AnterCreeper/gAFx/pickguard/pickguard.stl

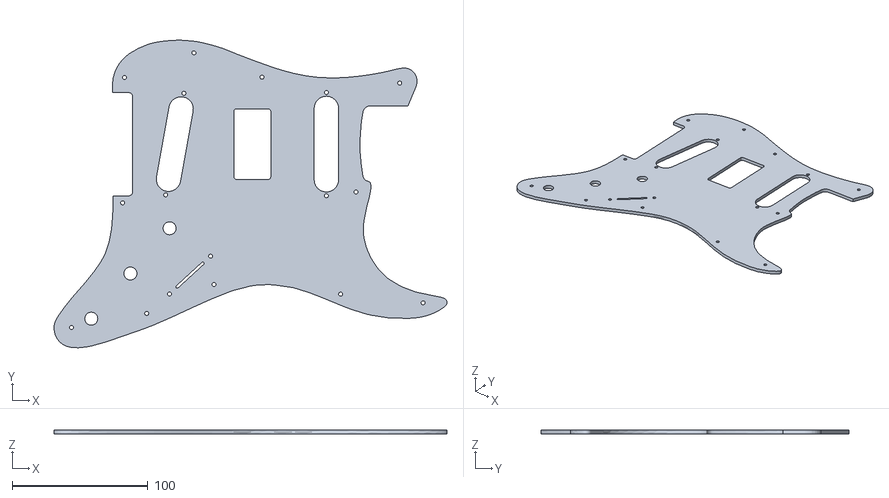
[picture p1: CAD file, 2025-06-01]
pickguard/pickguard.stl
289.1 x 226.3 x 3.00
