AnterCreeper/gAFx/(list of files, cad)

Other CAD files:
pickguard/pickguard.dxf
