AnterCreeper/gAFx/core/audio_lab.kicad_pcb

## KiCad design core/audio_lab.kicad_pcb (2025-06-01)

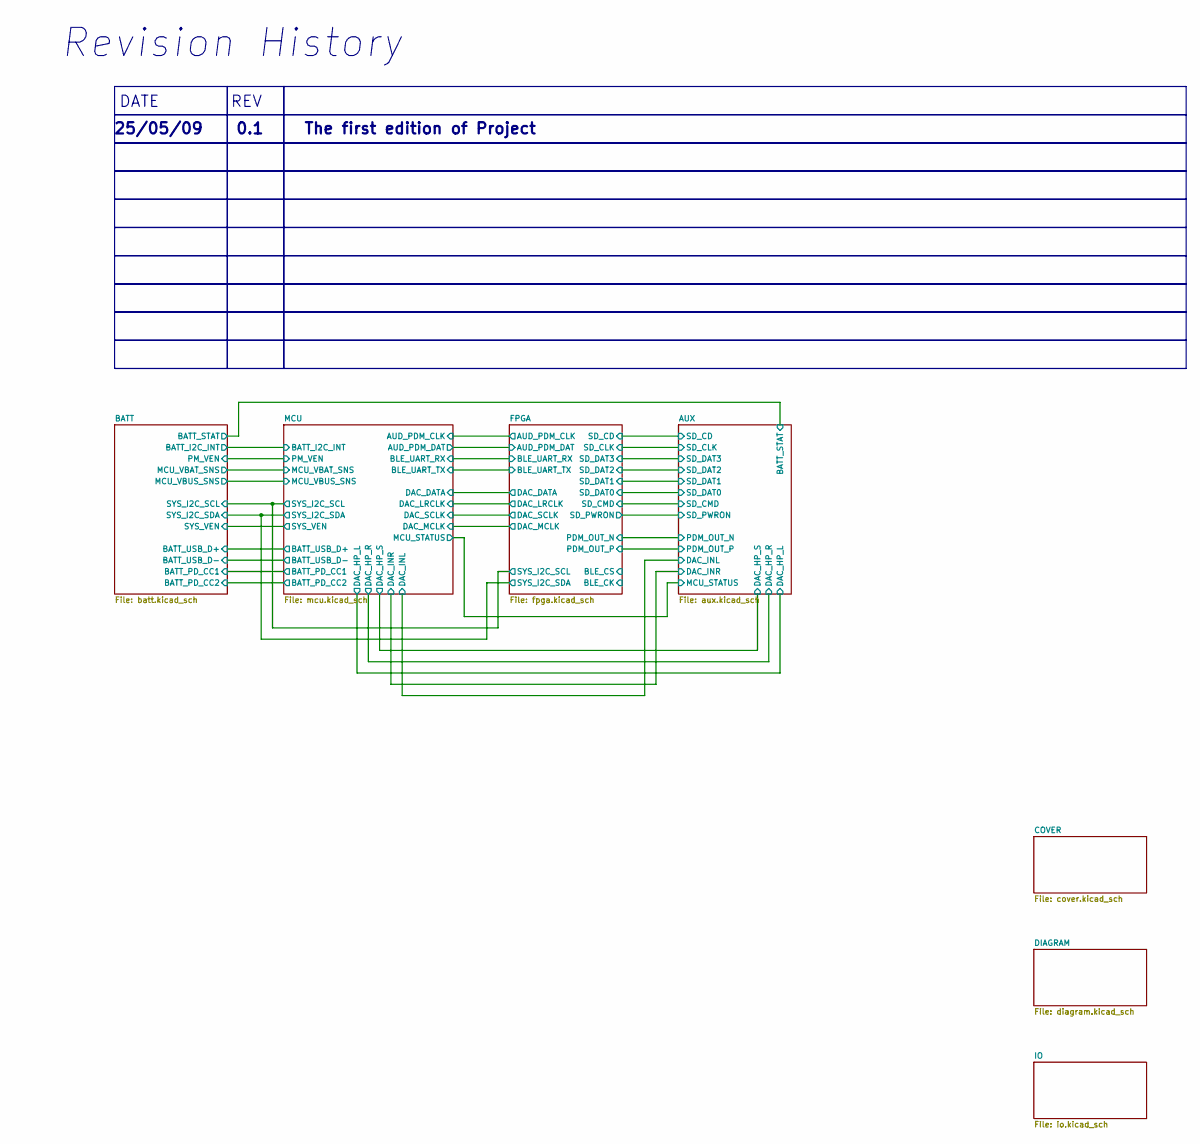
[picture p2: schematic audio_lab.kicad_sch]

Notes on the sheet:
Revision History
REV
0.1
25/05/09
The first edition of Project
DATE

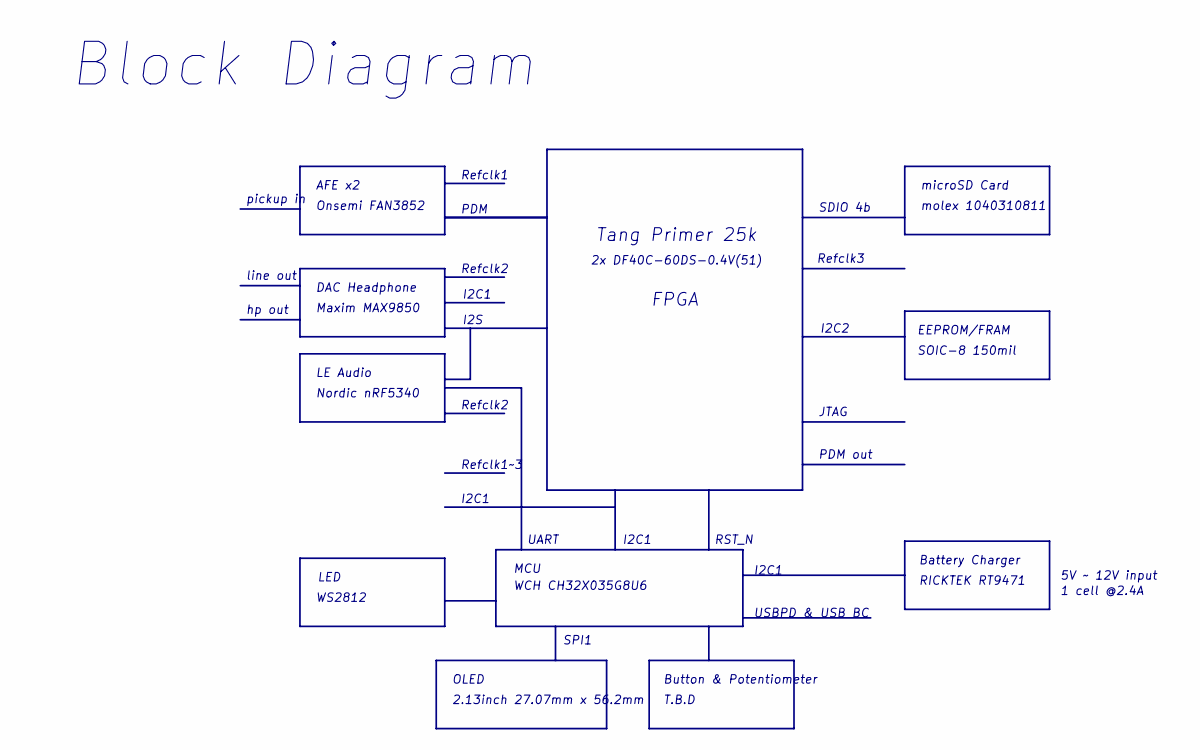
[picture p3: schematic diagram.kicad_sch]

Notes on the sheet:
T.B.D
Onsemi FAN3852
line out
FPGA
PDM out
WCH CH32X035G8U6
5V ~ 12V input
Refclk2
USBPD & USB BC
Refclk3
JTAG
EEPROM/FRAM
Refclk1
I2C1
hp out
WS2812
microSD Card
SOIC-8 150mil
Maxim MAX9850
OLED
RICKTEK RT9471
molex 1040310811
Nordic nRF5340
LE Audio
PDM
Button & Potentiometer
Block Diagram
LED
pickup in
UART
DAC Headphone
I2C2
SDIO 4b
2.13inch 27.07mm x 56.2mm
AFE x2
SPI1
2x DF40C-60DS-0.4V(51)
MCU
RST_N
I2S
Refclk1~3
Battery Charger
1 cell @2.4A
Tang Primer 25k

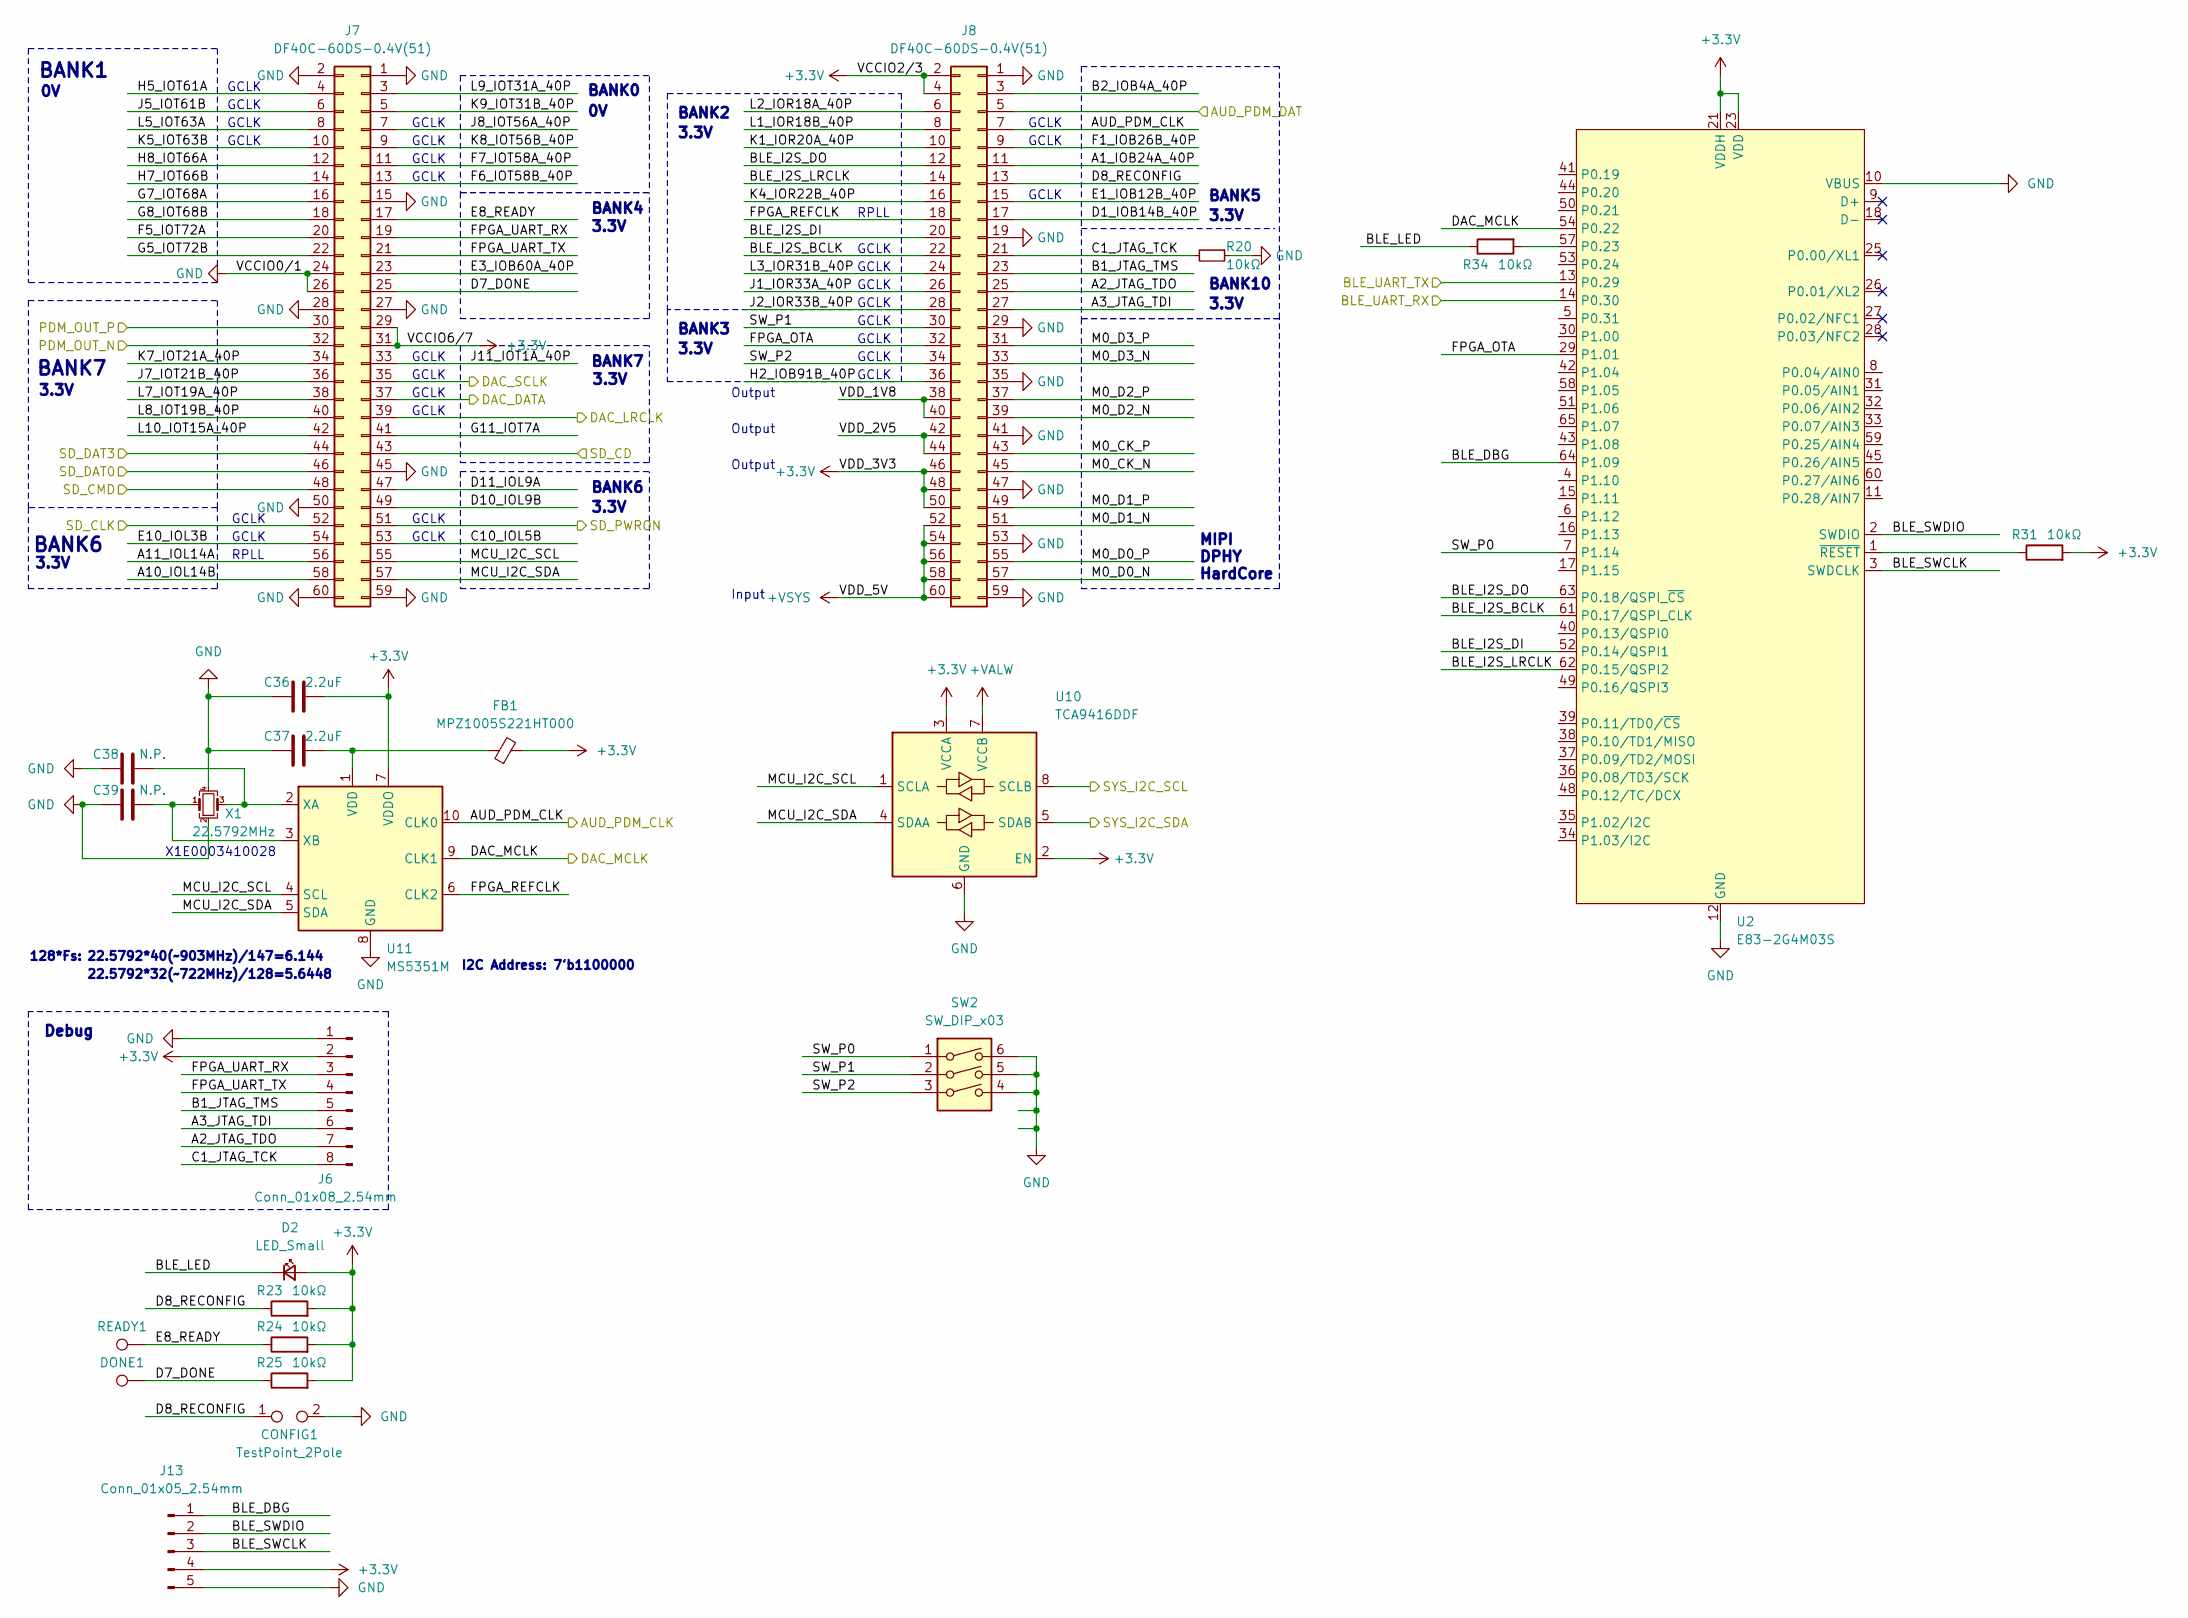
[picture p4: schematic fpga.kicad_sch]

Parts:
C36, C37: 2.2uF; C_0402_1005Metric
C38, C39: N.P.; C_0402_1005Metric
CONFIG1: TestPoint_2Pole; TestPoint_Bridge_Pitch2.0mm_Drill0.7mm
D2: LED_Small; D_0603_1608Metric
DONE1: TestPoint; TestPoint_Pad_D1.0mm
FB1: MPZ1005S221HT000; L_0402_1005Metric
J6: Conn_01x08_2.54mm; PinHeader_1x08_P2.54mm_Vertical
J7, J8: DF40C-60DS-0.4V(51); BTB-DF40C-60DS-0.4V(51)
J13: Conn_01x05_2.54mm; PinHeader_1x05_P2.54mm_Vertical
R20, R23, R24, R25, R31, R34: 10kΩ; R_0402_1005Metric
READY1: TestPoint; TestPoint_Pad_D1.0mm
SW2: SW_DIP_x03; SW_DIP_SPSTx03_Slide_KingTek_DSHP03TS_W7.62mm_P1.27mm
U2: E83-2G4M03S; E83-2G4M03S_16x16mm_LGA; LCSC C5333991
U10: TCA9416DDF; TSOT-23-8
U11: MS5351M; MSOP-10_3x3mm_P0.5mm
X1: 22.5792MHz; Crystal_SMD_3225-4Pin_3.2x2.5mm

Connections:
+3.3V: C36.2, D2.2 (A), FB1.2, J6.2, J7.29, J7.31, J8.2, J8.4, J8.46, J8.48, J8.50, J13.4, R23.2, R24.2, R25.2, R31.2, U2.21 (VDDH), U2.23 (VDD), U10.2 (EN), U10.3 (VCCA), U11.7 (VDDO); also elsewhere on the board
+VALW: U10.7 (VCCB); also elsewhere on the board
+VSYS: J8.52, J8.54, J8.56, J8.58, J8.60; also elsewhere on the board
/AUX/PDM_OUT_N: J7.32; also elsewhere on the board
/AUX/PDM_OUT_P: J7.30; also elsewhere on the board
/AUX/SD_CD: J7.43; also elsewhere on the board
/AUX/SD_CLK: J7.52; also elsewhere on the board
/AUX/SD_CMD: J7.48; also elsewhere on the board
/AUX/SD_DAT0: J7.46; also elsewhere on the board
/AUX/SD_DAT3: J7.44; also elsewhere on the board
/AUX/SD_PWRON: J7.51; also elsewhere on the board
/FPGA/A1_IOB24A_40P: J8.11
/FPGA/A2_JTAG_TDO: J6.7, J8.25
/FPGA/A3_JTAG_TDI: J6.6, J8.27
/FPGA/A10_IOL14B: J7.58
/FPGA/A11_IOL14A: J7.56
/FPGA/AUD_PDM_CLK: J8.7, U11.10 (CLK0); also elsewhere on the board
/FPGA/AUD_PDM_DAT: J8.5; also elsewhere on the board
/FPGA/B1_JTAG_TMS: J6.5, J8.23
/FPGA/B2_IOB4A_40P: J8.3
/FPGA/BLE_DBG: J13.1, U2.64 (P1.09)
/FPGA/BLE_I2S_BCLK: J8.22, U2.61 (P0.17/QSPI_CLK)
/FPGA/BLE_I2S_DI: J8.20, U2.52 (P0.14/QSPI1)
/FPGA/BLE_I2S_DO: J8.12, U2.63 (P0.18/QSPI_~CS)
/FPGA/BLE_I2S_LRCLK: J8.14, U2.62 (P0.15/QSPI2)
/FPGA/BLE_LED: D2.1 (K), R34.1
/FPGA/BLE_SWCLK: J13.3, U2.3 (SWDCLK)
/FPGA/BLE_SWDIO: J13.2, U2.2 (SWDIO)
/FPGA/BLE_UART_RX: U2.14 (P0.30); also elsewhere on the board
/FPGA/BLE_UART_TX: U2.13 (P0.29); also elsewhere on the board
/FPGA/C1_JTAG_TCK: J6.8, J8.21, R20.2
/FPGA/C10_IOL5B: J7.53
/FPGA/D1_IOB14B_40P: J8.17
/FPGA/D7_DONE: DONE1.1, J7.25, R25.1; also elsewhere on the board
/FPGA/D8_RECONFIG: CONFIG1.1, J8.13, R23.1; also elsewhere on the board
/FPGA/D10_IOL9B: J7.49
/FPGA/D11_IOL9A: J7.47
/FPGA/DAC_DATA: J7.37; also elsewhere on the board
/FPGA/DAC_LRCLK: J7.39; also elsewhere on the board
/FPGA/DAC_MCLK: U2.54 (P0.22), U11.9 (CLK1); also elsewhere on the board
/FPGA/DAC_SCLK: J7.35; also elsewhere on the board
/FPGA/E1_IOB12B_40P: J8.15
/FPGA/E3_IOB60A_40P: J7.23
/FPGA/E8_READY: J7.17, R24.1, READY1.1; also elsewhere on the board
/FPGA/E10_IOL3B: J7.54
/FPGA/F1_IOB26B_40P: J8.9
/FPGA/F5_IOT72A: J7.20
/FPGA/F6_IOT58B_40P: J7.13
/FPGA/F7_IOT58A_40P: J7.11
/FPGA/FPGA_OTA: J8.32, U2.29 (P1.01)
/FPGA/FPGA_REFCLK: J8.18, U11.6 (CLK2)
/FPGA/FPGA_UART_RX: J6.3, J7.19
/FPGA/FPGA_UART_TX: J6.4, J7.21
/FPGA/G5_IOT72B: J7.22
/FPGA/G7_IOT68A: J7.16
/FPGA/G8_IOT68B: J7.18
/FPGA/G11_IOT7A: J7.41
/FPGA/H2_IOB91B_40P: J8.36
/FPGA/H5_IOT61A: J7.4
/FPGA/H7_IOT66B: J7.14
/FPGA/H8_IOT66A: J7.12
/FPGA/J1_IOR33A_40P: J8.26
/FPGA/J2_IOR33B_40P: J8.28
/FPGA/J5_IOT61B: J7.6
/FPGA/J7_IOT21B_40P: J7.36
/FPGA/J8_IOT56A_40P: J7.7
/FPGA/J11_IOT1A_40P: J7.33
/FPGA/K1_IOR20A_40P: J8.10
/FPGA/K4_IOR22B_40P: J8.16
/FPGA/K5_IOT63B: J7.10
/FPGA/K7_IOT21A_40P: J7.34
/FPGA/K8_IOT56B_40P: J7.9
/FPGA/K9_IOT31B_40P: J7.5
/FPGA/L1_IOR18B_40P: J8.8
/FPGA/L2_IOR18A_40P: J8.6
/FPGA/L3_IOR31B_40P: J8.24
/FPGA/L5_IOT63A: J7.8
/FPGA/L7_IOT19A_40P: J7.38
/FPGA/L8_IOT19B_40P: J7.40
/FPGA/L9_IOT31A_40P: J7.3
/FPGA/L10_IOT15A_40P: J7.42
/FPGA/M0_CK_N: J8.45
/FPGA/M0_CK_P: J8.43
/FPGA/M0_D0_N: J8.57
/FPGA/M0_D0_P: J8.55
/FPGA/M0_D1_N: J8.51
/FPGA/M0_D1_P: J8.49
/FPGA/M0_D2_N: J8.39
/FPGA/M0_D2_P: J8.37
/FPGA/M0_D3_N: J8.33
/FPGA/M0_D3_P: J8.31
/FPGA/MCU_I2C_SCL: J7.55, U10.1 (SCLA), U11.4 (SCL)
/FPGA/MCU_I2C_SDA: J7.57, U10.4 (SDAA), U11.5 (SDA)
/FPGA/SW_P0: SW2.1, U2.7 (P1.14)
/FPGA/SW_P1: J8.30, SW2.2
/FPGA/SW_P2: J8.34, SW2.3
/FPGA/VDD_1V8: J8.38, J8.40
/FPGA/VDD_2V5: J8.42, J8.44
/MCU/MCU_I2C_SCL: U10.8 (SCLB); also elsewhere on the board
/MCU/MCU_I2C_SDA: U10.5 (SDAB); also elsewhere on the board
GND: C36.1, C37.1, C38.1, C39.1, CONFIG1.2, J6.1, J7.1, J7.2, J7.15, J7.24, J7.26, J7.27, J7.28, J7.45, J7.50, J7.59, J7.60, J8.1, J8.19, J8.29, J8.35, J8.41, J8.47, J8.53, J8.59, J13.5, R20.1, SW2.4, SW2.5, SW2.6, U2.10 (VBUS), U2.12 (GND), U2.19 (GND), U2.20 (GND), U2.22 (GND), U2.24 (GND), U2.46 (GND), U2.47 (GND), U2.55 (GND), U2.56 (GND), U10.6 (GND), U11.8 (GND), X1.2, X1.4; also elsewhere on the board
unnamed: R34.2, U2.57 (P0.23)
unnamed: R31.1, U2.1 (~RESET)
unnamed: C37.2, FB1.1, U11.1 (VDD)
unnamed: C38.2, U11.2 (XA), X1.3
unnamed: C39.2, U11.3 (XB), X1.1

Notes on the sheet:
GCLK
BANK6
RPLL
BANK2
22.5792*32(~722MHz)/128=5.6448
Debug
3.3V
BANK10
MIPI DPHY HardCore
BANK4
BANK5
X1E0003410028
Input
Output
BANK7
I2C Address: 7'b1100000
128*Fs:
BANK1
22.5792*40(~903MHz)/147=6.144
BANK3
BANK0

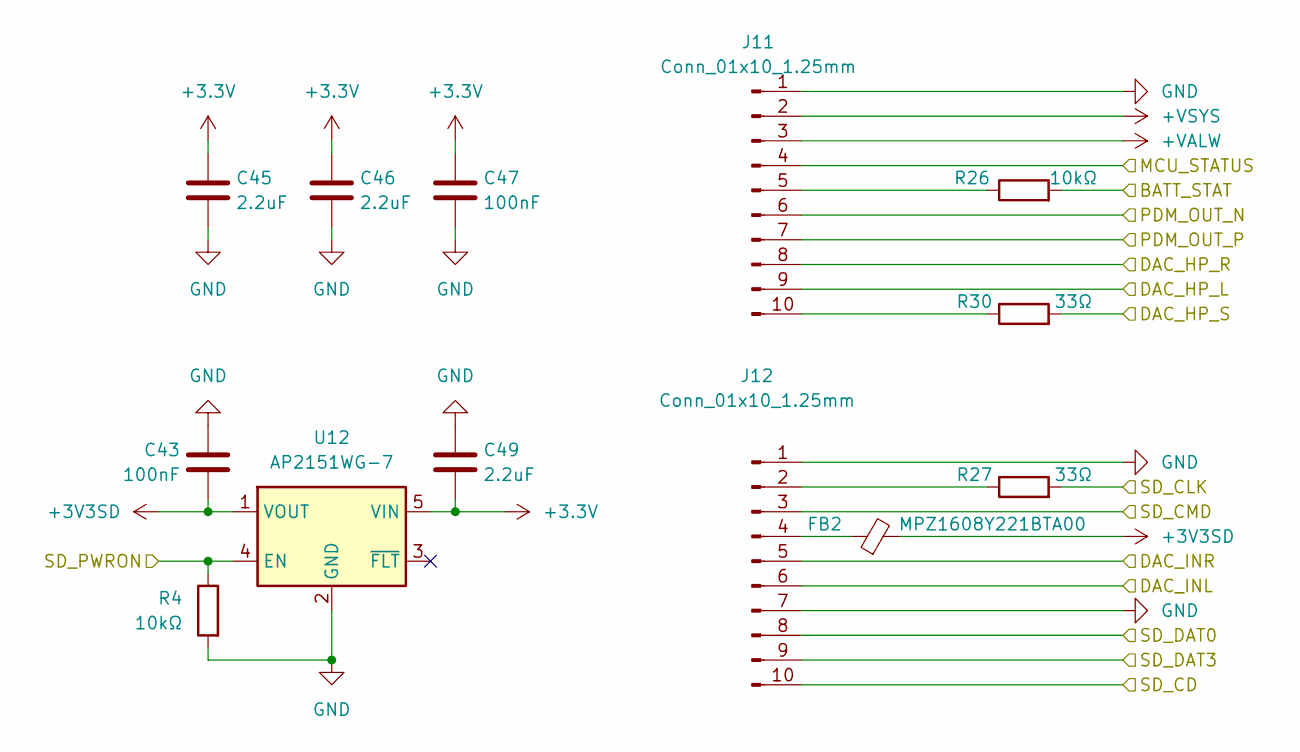
[picture p5: schematic aux.kicad_sch]

Parts:
C43, C47: 100nF; C_0402_1005Metric
C45, C46, C49: 2.2uF; C_0402_1005Metric
FB2: MPZ1608Y221BTA00; L_0603_1608Metric
J11, J12: Conn_01x10_1.25mm; Molex_PicoBlade_53047-1010_1x10_P1.25mm_Vertical
R4, R26: 10kΩ; R_0402_1005Metric
R27, R30: 33Ω; R_0402_1005Metric
U12: AP2151WG-7; SOT-23-5

Connections:
+3.3V: C45.1, C46.1, C47.1, C49.2, U12.5 (VIN); also elsewhere on the board
+3V3SD: C43.2, FB2.2, U12.1 (VOUT)
+VALW: J11.3; also elsewhere on the board
+VSYS: J11.2; also elsewhere on the board
/AUX/BATT_STAT: R26.2; also elsewhere on the board
/AUX/DAC_HP_L: J11.9; also elsewhere on the board
/AUX/DAC_HP_R: J11.8; also elsewhere on the board
/AUX/DAC_HP_S: R30.2; also elsewhere on the board
/AUX/DAC_INL: J12.6; also elsewhere on the board
/AUX/DAC_INR: J12.5; also elsewhere on the board
/AUX/MCU_STATUS: J11.4; also elsewhere on the board
/AUX/PDM_OUT_N: J11.6; also elsewhere on the board
/AUX/PDM_OUT_P: J11.7; also elsewhere on the board
/AUX/SD_CD: J12.10; also elsewhere on the board
/AUX/SD_CLK: R27.2; also elsewhere on the board
/AUX/SD_CMD: J12.3; also elsewhere on the board
/AUX/SD_DAT0: J12.8; also elsewhere on the board
/AUX/SD_DAT3: J12.9; also elsewhere on the board
/AUX/SD_PWRON: R4.1, U12.4 (EN); also elsewhere on the board
GND: C43.1, C45.2, C46.2, C47.2, C49.1, J11.1, J12.1, J12.7, R4.2, U12.2 (GND); also elsewhere on the board
unnamed: J11.5, R26.1
unnamed: J11.10, R30.1
unnamed: J12.2, R27.1
unnamed: FB2.1, J12.4

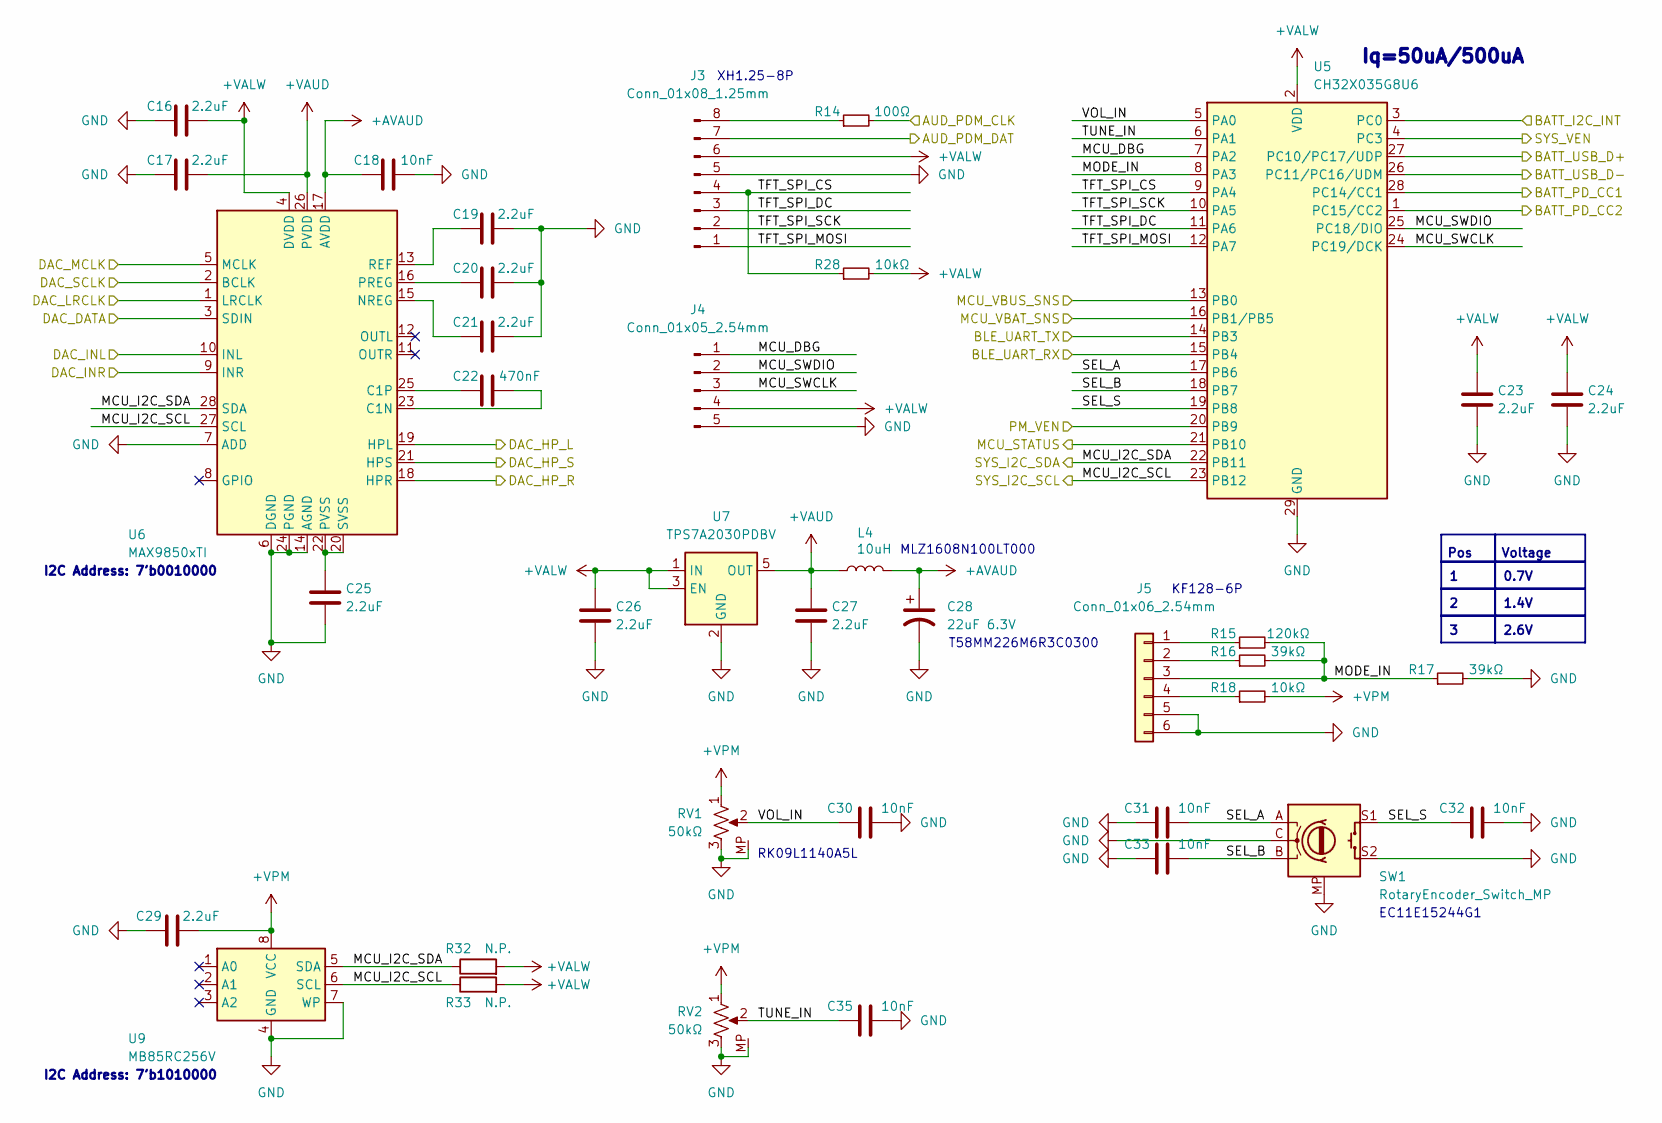
[picture p6: schematic mcu.kicad_sch]

Parts:
C16, C17, C19, C20, C21, C23, C24, C25, C26, C27, C29: 2.2uF; C_0402_1005Metric
C18, C30, C31, C32, C33, C35: 10nF; C_0402_1005Metric
C22: 470nF; C_0402_1005Metric
C28: 22uF 6.3V; CP_EIA-1608-08_AVX-J
J3: Conn_01x08_1.25mm; Molex_PicoBlade_53047-0810_1x08_P1.25mm_Vertical
J4: Conn_01x05_2.54mm; PinHeader_1x05_P2.54mm_Vertical
J5: Conn_01x06_2.54mm; PinSocket_1x06_P2.54mm_Vertical
L4: 10uH; L_0603_1608Metric
R14: 100Ω; R_0402_1005Metric
R15: 120kΩ; R_0402_1005Metric
R16, R17: 39kΩ; R_0402_1005Metric
R18, R28: 10kΩ; R_0402_1005Metric
R32, R33: N.P.; R_0402_1005Metric
RV1, RV2: 50kΩ; Potentiometer_Alpha_RD901F-40-00D_Single_Vertical
SW1: RotaryEncoder_Switch_MP; RotaryEncoder_Favor_FEC11_Vertical_H15mm
U5: CH32X035G8U6; QFN-28-1EP_4x4mm_P0.4mm_EP2.7x2.7mm
U6: MAX9850xTI; TQFN-28-1EP_5x5mm_P0.5mm_EP3.25x3.25mm_ThermalVias
U7: TPS7A2030PDBV; SOT-23-5
U9: MB85RC256V; SOIC-8_3.9x4.9mm_P1.27mm

Connections:
+AVAUD: C18.1, C28.1, L4.2, U6.17 (AVDD)
+VALW: C16.2, C23.1, C24.1, C26.1, J3.6, J4.4, R28.2, R32.2, R33.2, U5.2 (VDD), U6.4 (DVDD), U7.1 (IN), U7.3 (EN); also elsewhere on the board
+VAUD: C17.2, C27.1, L4.1, U6.26 (PVDD), U7.5 (OUT)
+VPM: C29.2, R18.2, RV1.1, RV2.1, U9.8 (VCC); also elsewhere on the board
/AUX/DAC_HP_L: U6.19 (HPL); also elsewhere on the board
/AUX/DAC_HP_R: U6.18 (HPR); also elsewhere on the board
/AUX/DAC_HP_S: U6.21 (HPS); also elsewhere on the board
/AUX/DAC_INL: U6.10 (INL); also elsewhere on the board
/AUX/DAC_INR: U6.9 (INR); also elsewhere on the board
/AUX/MCU_STATUS: U5.21 (PB10); also elsewhere on the board
/BATT/BATT_I2C_INT: U5.3 (PC0); also elsewhere on the board
/BATT/BATT_PD_CC1: U5.28 (PC14/CC1); also elsewhere on the board
/BATT/BATT_PD_CC2: U5.1 (PC15/CC2); also elsewhere on the board
/BATT/BATT_USB_D+: U5.27 (PC10/PC17/UDP); also elsewhere on the board
/BATT/BATT_USB_D-: U5.26 (PC11/PC16/UDM); also elsewhere on the board
/BATT/MCU_VBAT_SNS: U5.16 (PB1/PB5); also elsewhere on the board
/BATT/MCU_VBUS_SNS: U5.13 (PB0); also elsewhere on the board
/BATT/PM_VEN: U5.20 (PB9); also elsewhere on the board
/BATT/SYS_VEN: U5.4 (PC3); also elsewhere on the board
/FPGA/AUD_PDM_CLK: R14.2; also elsewhere on the board
/FPGA/AUD_PDM_DAT: J3.7; also elsewhere on the board
/FPGA/BLE_UART_RX: U5.15 (PB4); also elsewhere on the board
/FPGA/BLE_UART_TX: U5.14 (PB3); also elsewhere on the board
/FPGA/DAC_DATA: U6.3 (SDIN); also elsewhere on the board
/FPGA/DAC_LRCLK: U6.1 (LRCLK); also elsewhere on the board
/FPGA/DAC_MCLK: U6.5 (MCLK); also elsewhere on the board
/FPGA/DAC_SCLK: U6.2 (BCLK); also elsewhere on the board
/MCU/MCU_DBG: J4.1, U5.7 (PA2)
/MCU/MCU_I2C_SCL: R33.1, U5.23 (PB12), U6.27 (SCL), U9.6 (SCL); also elsewhere on the board
/MCU/MCU_I2C_SDA: R32.1, U5.22 (PB11), U6.28 (SDA), U9.5 (SDA); also elsewhere on the board
/MCU/MCU_SWCLK: J4.3, U5.24 (PC19/DCK)
/MCU/MCU_SWDIO: J4.2, U5.25 (PC18/DIO)
/MCU/MODE_IN: J5.3, R15.2, R16.2, R17.1, U5.8 (PA3)
/MCU/SEL_A: C31.2, SW1.A, U5.17 (PB6)
/MCU/SEL_B: C33.2, SW1.B, U5.18 (PB7)
/MCU/SEL_S: C32.1, SW1.S1, U5.19 (PB8)
/MCU/TFT_SPI_CS: J3.4, R28.1, U5.9 (PA4)
/MCU/TFT_SPI_DC: J3.3, U5.11 (PA6)
/MCU/TFT_SPI_MOSI: J3.1, U5.12 (PA7)
/MCU/TFT_SPI_SCK: J3.2, U5.10 (PA5)
/MCU/TUNE_IN: C35.1, RV2.2, U5.6 (PA1)
/MCU/VOL_IN: C30.1, RV1.2, U5.5 (PA0)
GND: C16.1, C17.1, C18.2, C19.2, C20.2, C21.2, C23.2, C24.2, C25.2, C26.2, C27.2, C28.2, C29.1, C30.2, C31.1, C32.2, C33.1, C35.2, J3.5, J4.5, J5.5, J5.6, R17.2, RV1.3, RV1.MP, RV2.3, RV2.MP, SW1.C, SW1.MP, SW1.S2, U5.29 (GND), U6.6 (DGND), U6.7 (ADD), U6.14 (AGND), U6.24 (PGND), U6.29 (AGND), U7.2 (GND), U9.4 (GND), U9.7 (WP); also elsewhere on the board
unnamed: J3.8, R14.1
unnamed: J5.1, R15.1
unnamed: J5.2, R16.1
unnamed: J5.4, R18.1
unnamed: C22.2, U6.23 (C1N)
unnamed: C22.1, U6.25 (C1P)
unnamed: C21.1, U6.15 (NREG)
unnamed: C20.1, U6.16 (PREG)
unnamed: C25.1, U6.20 (SVSS), U6.22 (PVSS)
unnamed: C19.1, U6.13 (REF)

Notes on the sheet:
T58MM226M6R3C0300
Pos
Iq=50uA/500uA
RK09L1140A5L
MLZ1608N100LT000
0.7V
1.4V
XH1.25-8P
2.6V
I2C Address: 7'b1010000
Voltage
I2C Address: 7'b0010000
KF128-6P
EC11E15244G1

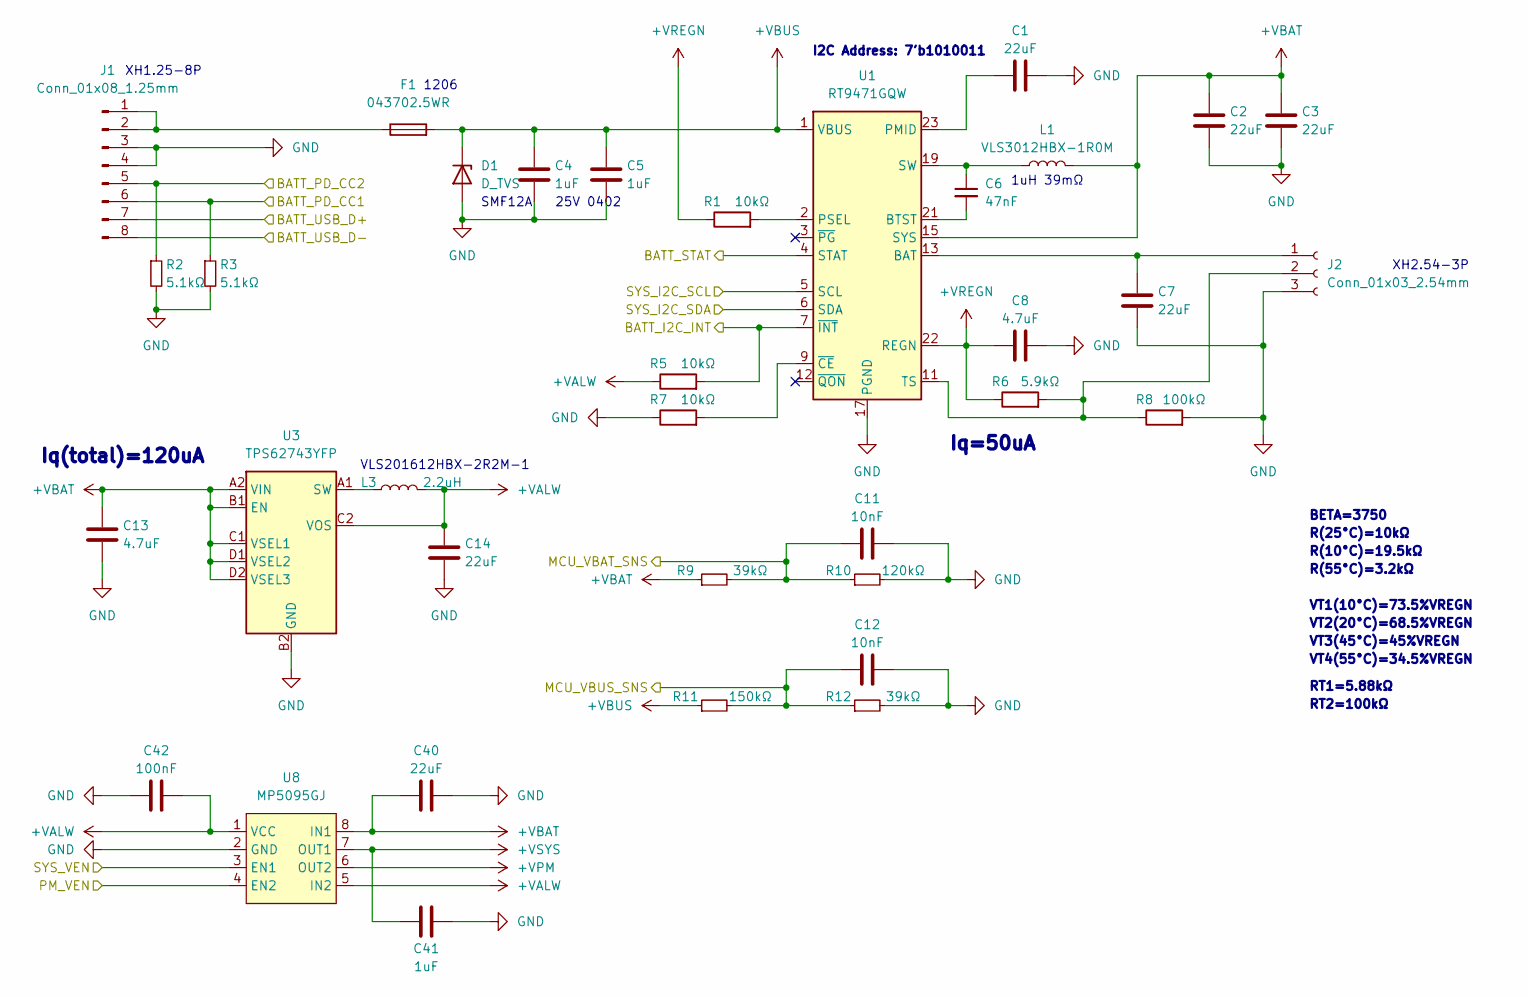
[picture p7: schematic batt.kicad_sch]

Parts:
C1, C2, C3, C7, C14, C40: 22uF; C_0603_1608Metric
C4, C5, C41: 1uF; C_0402_1005Metric
C6: 47nF; C_0402_1005Metric
C8, C13: 4.7uF; C_0402_1005Metric
C11, C12: 10nF; C_0402_1005Metric
C42: 100nF; C_0402_1005Metric
D1: D_TVS; D_PowerDI-123
F1: 043702.5WR; Fuse_1206_3216Metric
J1: Conn_01x08_1.25mm; Molex_PicoBlade_53047-0810_1x08_P1.25mm_Vertical
J2: Conn_01x03_2.54mm; JST_XH_B3B-XH-A_1x03_P2.50mm_Vertical
L1: VLS3012HBX-1R0M; L_TDK_VLS3012HBX
L3: 2.2uH; L_Murata_DFE201610P
R1, R5, R7: 10kΩ; R_0402_1005Metric
R2, R3: 5.1kΩ; R_0402_1005Metric
R6: 5.9kΩ; R_0402_1005Metric
R8: 100kΩ; R_0402_1005Metric
R9, R12: 39kΩ; R_0402_1005Metric
R10: 120kΩ; R_0402_1005Metric
R11: 150kΩ; R_0402_1005Metric
U1: RT9471GQW; RICKTEK_WQFN-24-1EP_4x4mm_P0.5mm_EP2.6x2.6mm_ThermalVias
U3: TPS62743YFP; Texas_DSBGA-8_0.86x1.56mm_Layout2x4_P0.4mm
U8: MP5095GJ; TSOT-23-8

Connections:
+VALW: C14.1, C42.2, L3.2, R5.1, U3.C2 (VOS), U8.1 (VCC), U8.5 (IN2); also elsewhere on the board
+VBAT: C2.1, C3.1, C13.1, C40.1, L1.2, R9.1, U1.15 (SYS), U1.16 (SYS), U3.A2 (VIN), U3.B1 (EN), U3.C1 (VSEL1), U3.D1 (VSEL2), U3.D2 (VSEL3), U8.8 (IN1)
+VBUS: C4.1, C5.1, D1.1 (K), F1.2, R11.1, U1.1 (VBUS), U1.24 (VBUS)
+VPM: U8.6 (OUT2); also elsewhere on the board
+VREGN: C8.1, R1.1, R6.1, U1.22 (REGN)
+VSYS: C41.1, U8.7 (OUT1); also elsewhere on the board
/AUX/BATT_STAT: U1.4 (STAT); also elsewhere on the board
/BATT/BATT_I2C_INT: R5.2, U1.7 (~INT); also elsewhere on the board
/BATT/BATT_PD_CC1: J1.6, R3.1; also elsewhere on the board
/BATT/BATT_PD_CC2: J1.5, R2.1; also elsewhere on the board
/BATT/BATT_USB_D+: J1.7; also elsewhere on the board
/BATT/BATT_USB_D-: J1.8; also elsewhere on the board
/BATT/MCU_VBAT_SNS: C11.1, R9.2, R10.1; also elsewhere on the board
/BATT/MCU_VBUS_SNS: C12.1, R11.2, R12.1; also elsewhere on the board
/BATT/PM_VEN: U8.4 (EN2); also elsewhere on the board
/BATT/SYS_VEN: U8.3 (EN1); also elsewhere on the board
/MCU/MCU_I2C_SCL: U1.5 (SCL); also elsewhere on the board
/MCU/MCU_I2C_SDA: U1.6 (SDA); also elsewhere on the board
GND: C1.2, C2.2, C3.2, C4.2, C5.2, C7.2, C8.2, C11.2, C12.2, C13.2, C14.2, C40.2, C41.2, C42.1, D1.2 (A), J1.3, J1.4, J2.3, R2.2, R3.2, R7.1, R8.2, R10.2, R12.2, U1.17 (PGND), U1.18 (PGND), U1.25 (PGND), U3.B2 (GND), U8.2 (GND); also elsewhere on the board
unnamed: C6.1, L1.1, U1.19 (SW), U1.20 (SW)
unnamed: F1.1, J1.1, J1.2
unnamed: C7.1, J2.1, U1.13 (BAT), U1.14 (BAT)
unnamed: J2.2, R6.2, R8.1, U1.11 (TS)
unnamed: C6.2, U1.21 (BTST)
unnamed: C1.1, U1.23 (PMID)
unnamed: R1.2, U1.2 (PSEL)
unnamed: R7.2, U1.9 (~CE)
unnamed: L3.1, U3.A1 (SW)

Notes on the sheet:
1uH 39mΩ
RT2=100kΩ
VT2(20°C)=68.5%VREGN
Iq(total)=120uA
XH2.54-3P
BETA=3750
VLS201612HBX-2R2M-1
VT4(55°C)=34.5%VREGN
Iq=50uA
25V 0402
VT1(10°C)=73.5%VREGN
XH1.25-8P
RT1=5.88kΩ
VT3(45°C)=45%VREGN
R(10°C)=19.5kΩ
1206
R(55°C)=3.2kΩ
R(25°C)=10kΩ
I2C Address: 7'b1010011
SMF12A

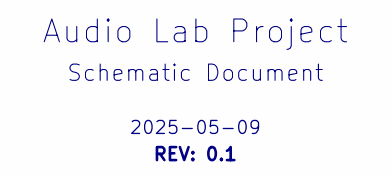
[picture p8: schematic cover.kicad_sch]

Notes on the sheet:
2025-05-09
Schematic Document
REV: 0.1
Audio Lab Project

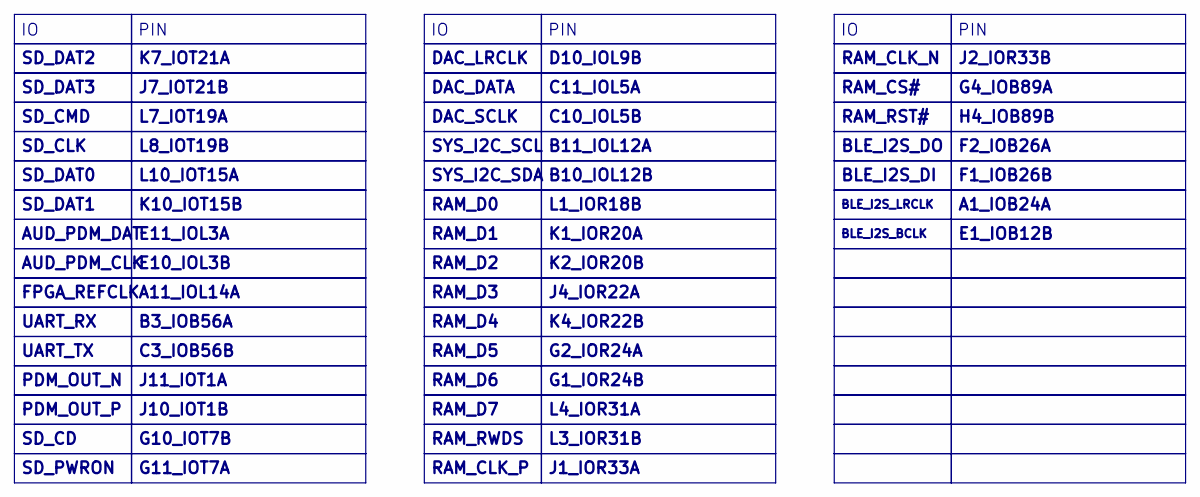
[picture p9: schematic io.kicad_sch]

Notes on the sheet:
E10_IOL3B
E1_IOB12B
BLE_I2S_LRCLK
UART_RX
G10_IOT7B
RAM_RWDS
RAM_RST#
C3_IOB56B
C10_IOL5B
F2_IOB26A
K7_IOT21A
A1_IOB24A
SYS_I2C_SCL
RAM_CLK_P
G11_IOT7A
AUD_PDM_DAT
SD_PWRON
RAM_CS#
G4_IOB89A
J10_IOT1B
K10_IOT15B
UART_TX
K1_IOR20A
K4_IOR22B
DAC_DATA
B10_IOL12B
SD_CLK
G1_IOR24B
H4_IOB89B
RAM_D5
G2_IOR24A
L1_IOR18B
L8_IOT19B
F1_IOB26B
RAM_D1
BLE_I2S_DO
PIN
SD_DAT1
AUD_PDM_CLK
SD_CMD
K2_IOR20B
DAC_LRCLK
BLE_I2S_BCLK
FPGA_REFCLK
PDM_OUT_P
L7_IOT19A
L4_IOR31A
J1_IOR33A
SD_DAT3
B11_IOL12A
J7_IOT21B
D10_IOL9B
B3_IOB56A
E11_IOL3A
RAM_D0
RAM_D6
A11_IOL14A
SD_DAT2
RAM_D4
DAC_SCLK
J11_IOT1A
SD_DAT0
BLE_I2S_DI
C11_IOL5A
RAM_CLK_N
SD_CD
SYS_I2C_SDA
J4_IOR22A
J2_IOR33B
RAM_D3
L10_IOT15A
PDM_OUT_N
L3_IOR31B
RAM_D2
RAM_D7

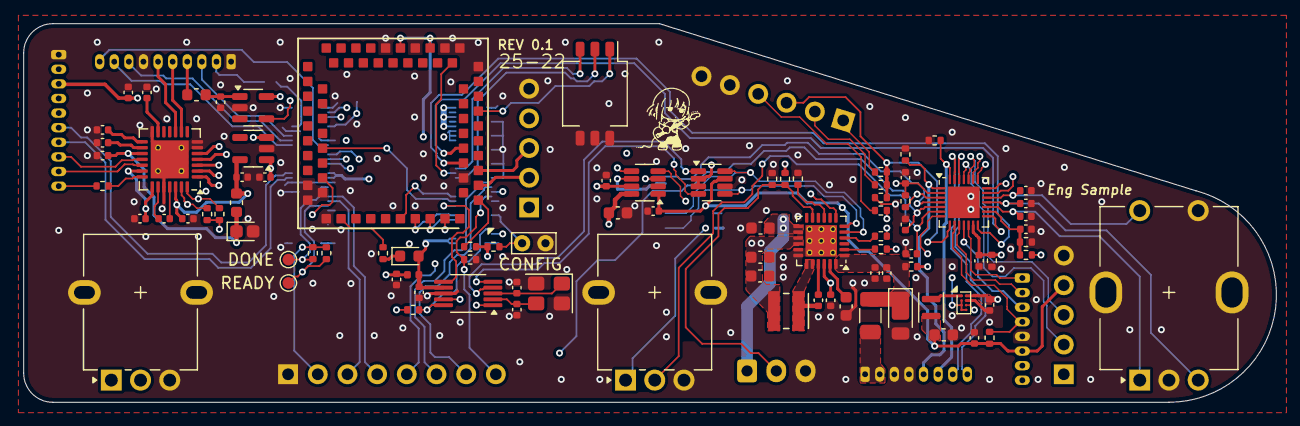
[picture p10: board core/audio_lab.kicad_pcb from above]

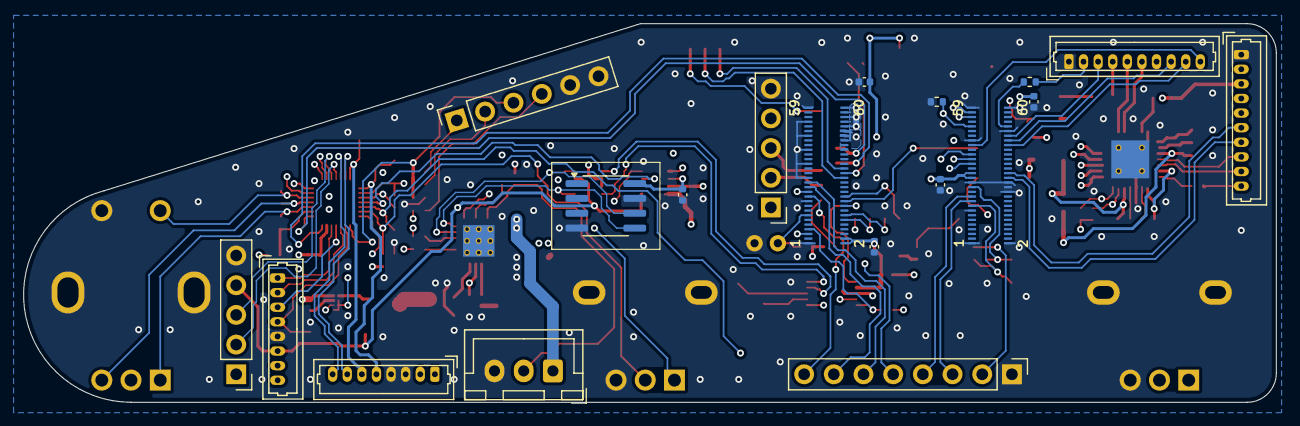
[picture p11: board core/audio_lab.kicad_pcb from below]

Board: 4 copper layers, 107.2 x 32.4 mm, 110 parts (19 on the bottom side), 112 nets.

Other parts of the board:
CONFIG: TestPoint_2Pole; TestPoint_Bridge_Pitch2.0mm_Drill0.7mm
DONE: TestPoint; TestPoint_Pad_D1.0mm
READY: TestPoint; TestPoint_Pad_D1.0mm

Their connections:
/FPGA/D7_DONE: DONE.1; also elsewhere on the board
/FPGA/D8_RECONFIG: CONFIG.1; also elsewhere on the board
/FPGA/E8_READY: READY.1; also elsewhere on the board
GND: CONFIG.2; also elsewhere on the board
