AnterCreeper/gAFx/pickup/audio_lab.kicad_pcb

## KiCad design pickup/audio_lab.kicad_pcb (2025-06-01)

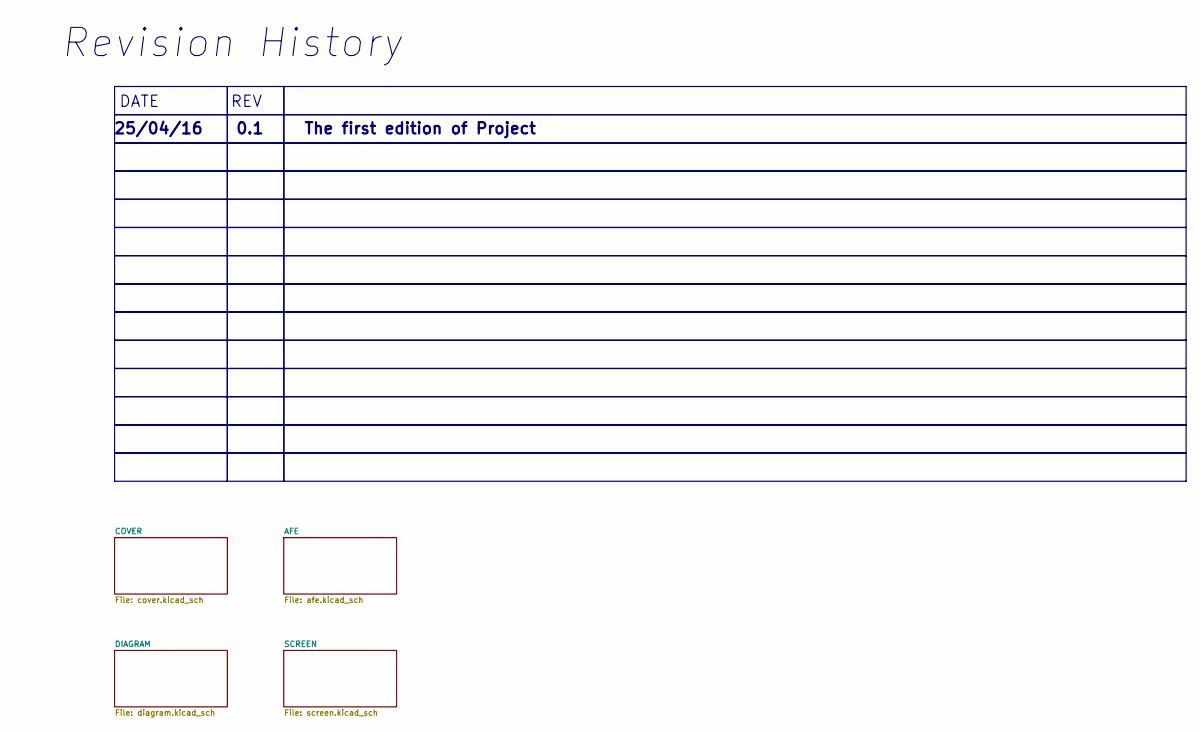
[picture p12: schematic audio_lab.kicad_sch]

Notes on the sheet:
Revision History
REV
0.1
25/04/16
The first edition of Project
DATE
