AnterCreeper/gAFx/pickup/audio_lab.kicad_pcb

## KiCad design pickup/audio_lab.kicad_pcb (continued)

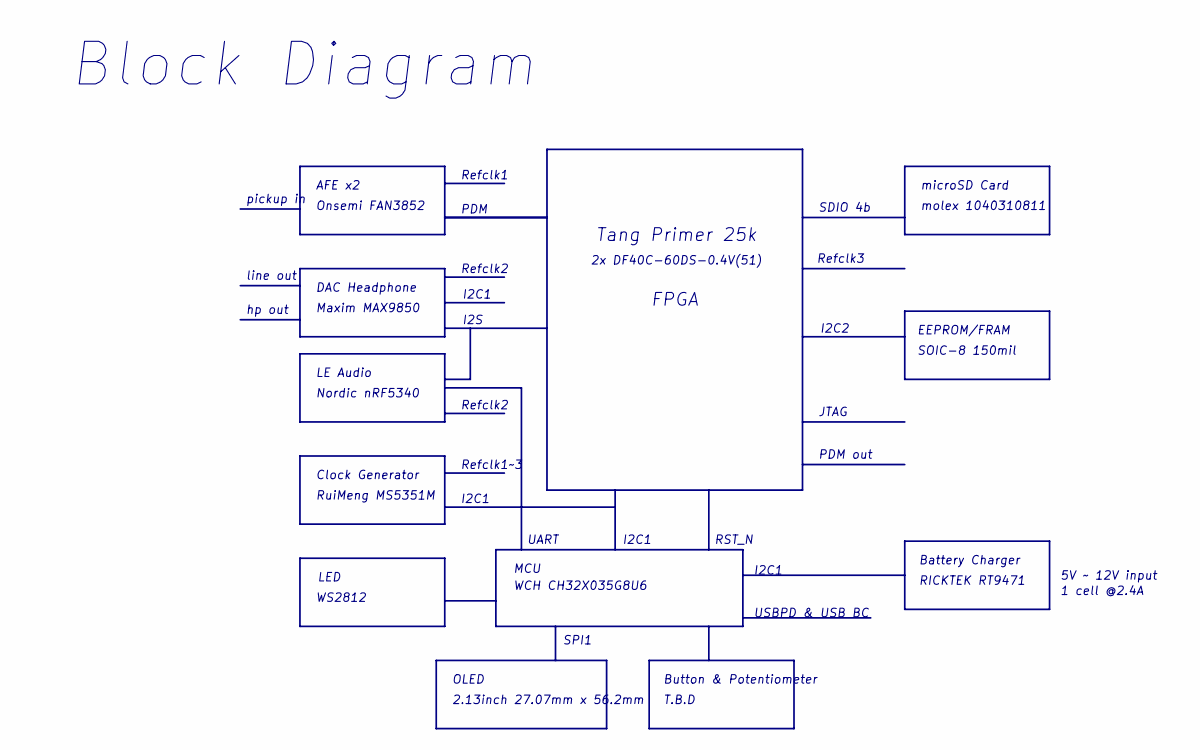
[picture p13: schematic diagram.kicad_sch]

Notes on the sheet:
T.B.D
Onsemi FAN3852
Clock Generator
line out
FPGA
PDM out
WCH CH32X035G8U6
5V ~ 12V input
Refclk2
RuiMeng MS5351M
USBPD & USB BC
Refclk3
JTAG
EEPROM/FRAM
Refclk1
I2C1
hp out
WS2812
microSD Card
SOIC-8 150mil
Maxim MAX9850
OLED
RICKTEK RT9471
molex 1040310811
Nordic nRF5340
LE Audio
PDM
Button & Potentiometer
Block Diagram
LED
pickup in
UART
DAC Headphone
I2C2
SDIO 4b
2.13inch 27.07mm x 56.2mm
AFE x2
SPI1
2x DF40C-60DS-0.4V(51)
MCU
RST_N
I2S
Refclk1~3
Battery Charger
1 cell @2.4A
Tang Primer 25k

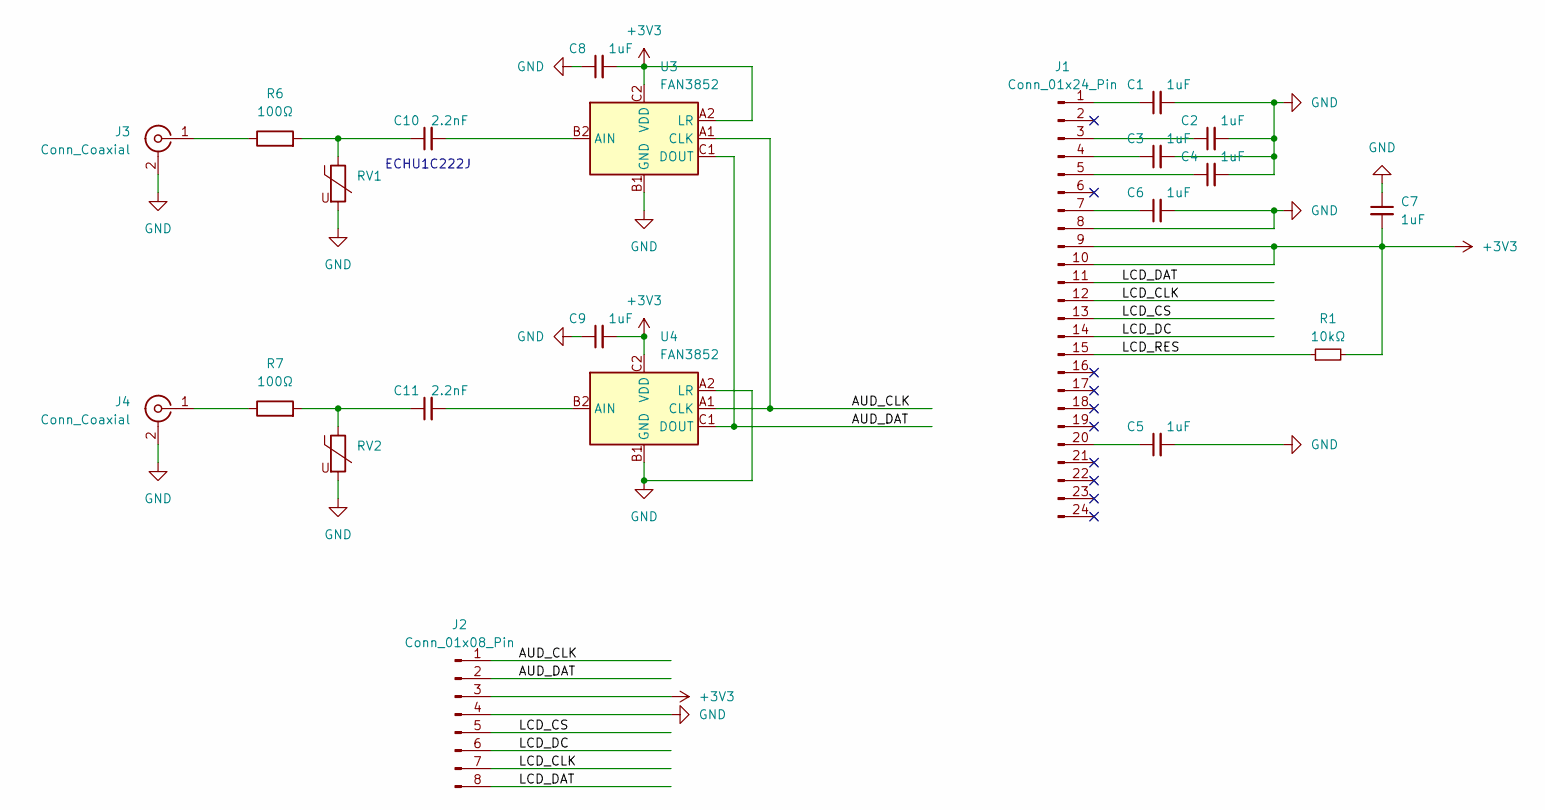
[picture p14: schematic afe.kicad_sch]

Parts:
C1, C2, C3, C4, C5, C6, C7, C8, C9: 1uF; C_0402_1005Metric
C10, C11: 2.2nF; C_0603_1608Metric
J1: Conn_01x24_Pin; TE_2-1734839-4_1x24-1MP_P0.5mm_Horizontal
J2: Conn_01x08_Pin; PinSocket_1x08_P1.27mm_Vertical
J3, J4: Conn_Coaxial; IPEX_20449-001E-03
R1: 10kΩ; R_0402_1005Metric
R6, R7: 100Ω; R_0402_1005Metric
RV1, RV2: Varistor; R_0402_1005Metric
U3, U4: FAN3852; Texas_DSBGA-6_0.855x1.255mm_Layout2x3_P0.4mm_LevelC

Connections:
+3V3: C7.2, C8.2, C9.2, J1.9, J1.10, J2.3, R1.2, U3.A2 (LR), U3.C2 (VDD), U4.C2 (VDD)
/AFE/AUD_CLK: J2.1, U3.A1 (CLK), U4.A1 (CLK)
/AFE/AUD_DAT: J2.2, U3.C1 (DOUT), U4.C1 (DOUT)
/AFE/LCD_CLK: J1.12, J2.7
/AFE/LCD_CS: J1.13, J2.5
/AFE/LCD_DAT: J1.11, J2.8
/AFE/LCD_DC: J1.14, J2.6
/AFE/LCD_RES: J1.15, R1.1
GND: C1.2, C2.2, C3.2, C4.2, C5.2, C6.2, C7.1, C8.1, C9.1, J1.8, J1.MP, J2.4, J3.2 (Ext), J4.2 (Ext), RV1.2, RV2.2, U3.3 (GND), U3.B1 (GND), U4.3 (GND), U4.A2 (LR), U4.B1 (GND)
unnamed: C10.1, R6.2, RV1.1
unnamed: C11.1, R7.2, RV2.1
unnamed: C1.1, J1.1
unnamed: C2.1, J1.3
unnamed: C3.1, J1.4
unnamed: C4.1, J1.5
unnamed: C6.1, J1.7
unnamed: C5.1, J1.20
unnamed: J3.1 (In), R6.1
unnamed: J4.1 (In), R7.1
unnamed: C10.2, U3.B2 (AIN)
unnamed: C11.2, U4.B2 (AIN)

Notes on the sheet:
ECHU1C222J

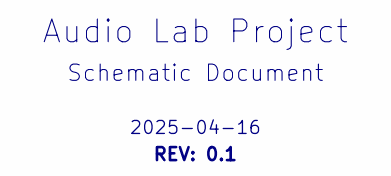
[picture p15: schematic cover.kicad_sch]

Notes on the sheet:
2025-04-16
Schematic Document
REV: 0.1
Audio Lab Project

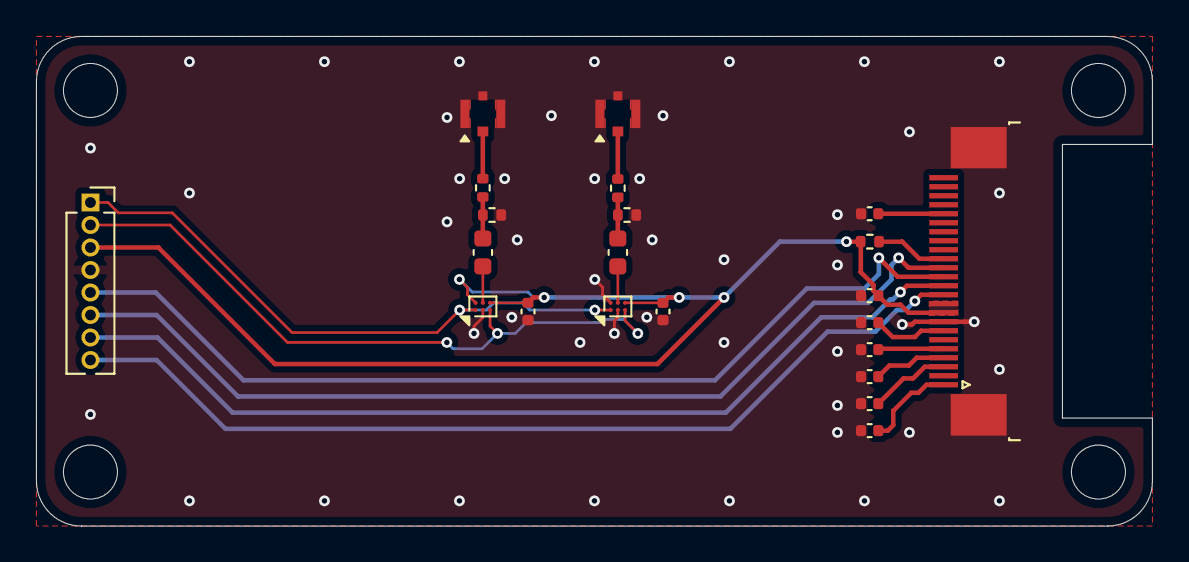
[picture p16: board pickup/audio_lab.kicad_pcb from above]

Board: 2 copper layers, 62.0 x 27.2 mm, 22 parts (0 on the bottom side), 21 nets.
